f4ise/RemoteAnyToneD578/Docs/Arduino/digispark_attiny85_pinout.jpg

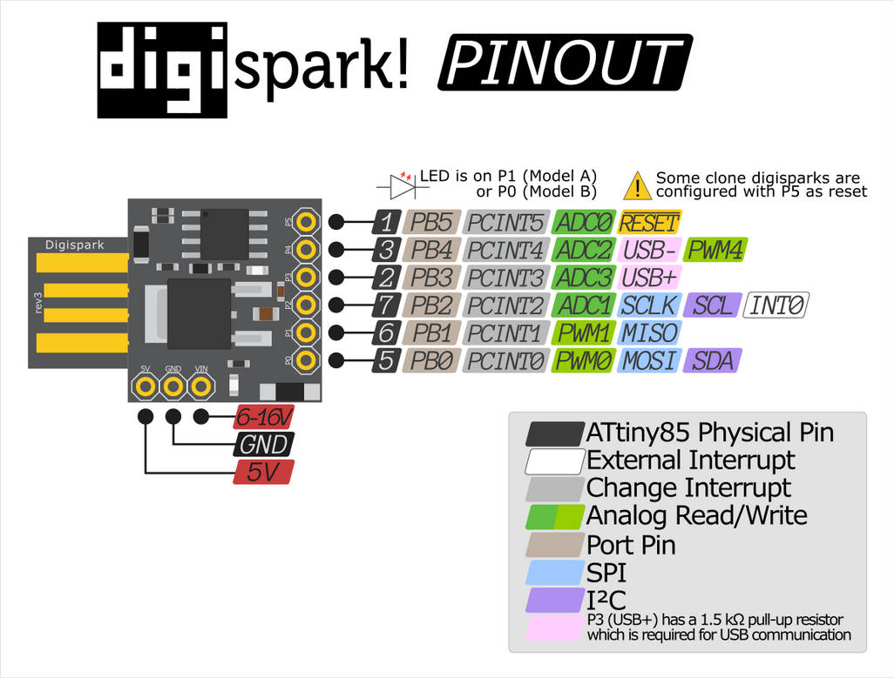
Docs/Arduino/digispark_attiny85_pinout.jpg
