f4ise/RemoteAnyToneD578/Docs/ds3231_schematic.png

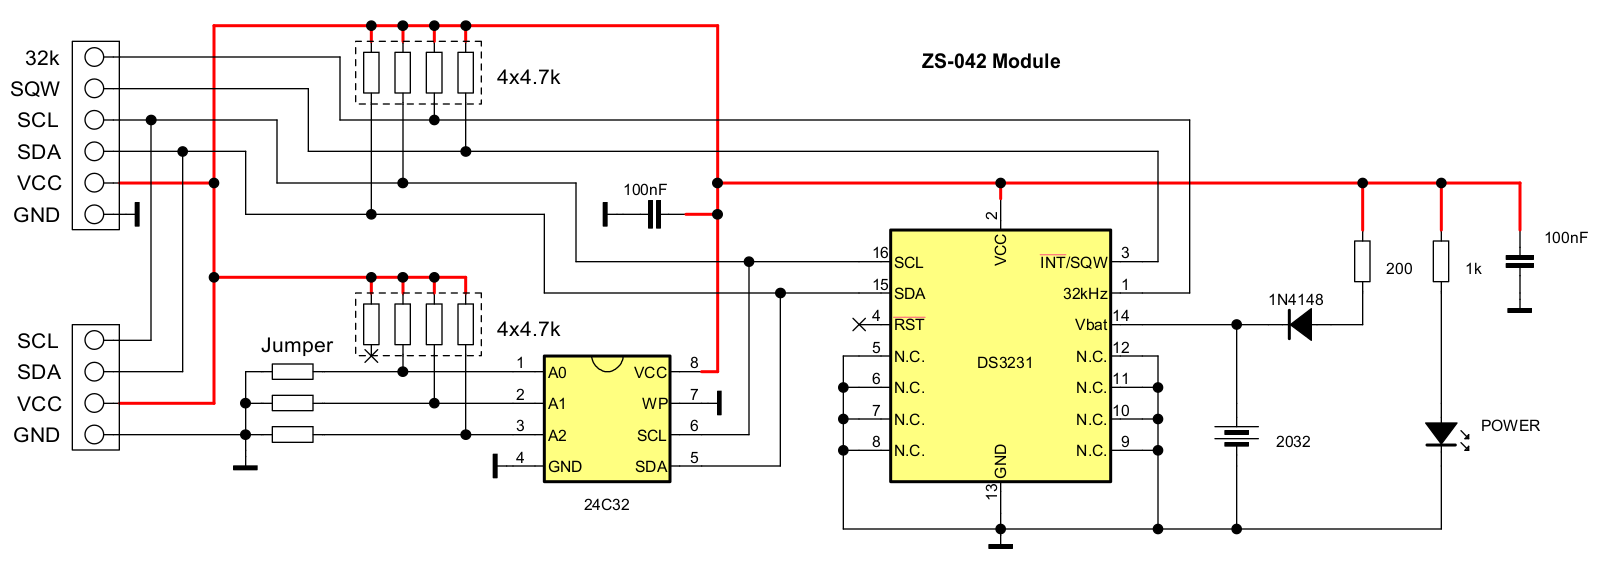
Docs/ds3231_schematic.png
