f4ise/RemoteAnyToneD578/Docs/Kenwoodbaofengcombdiag.png

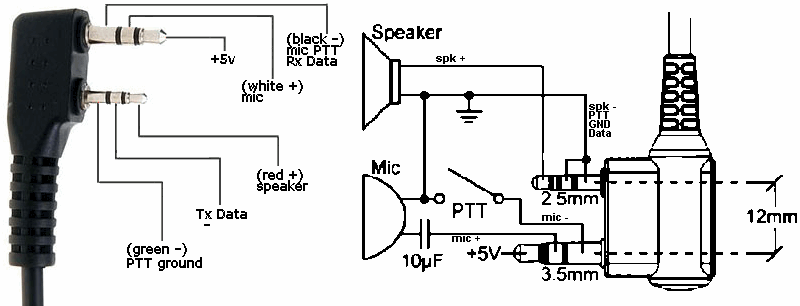
Docs/Kenwoodbaofengcombdiag.png
