f4ise/RemoteAnyToneD578/Docs/MT8870-DTMF-Module-Schematic.png

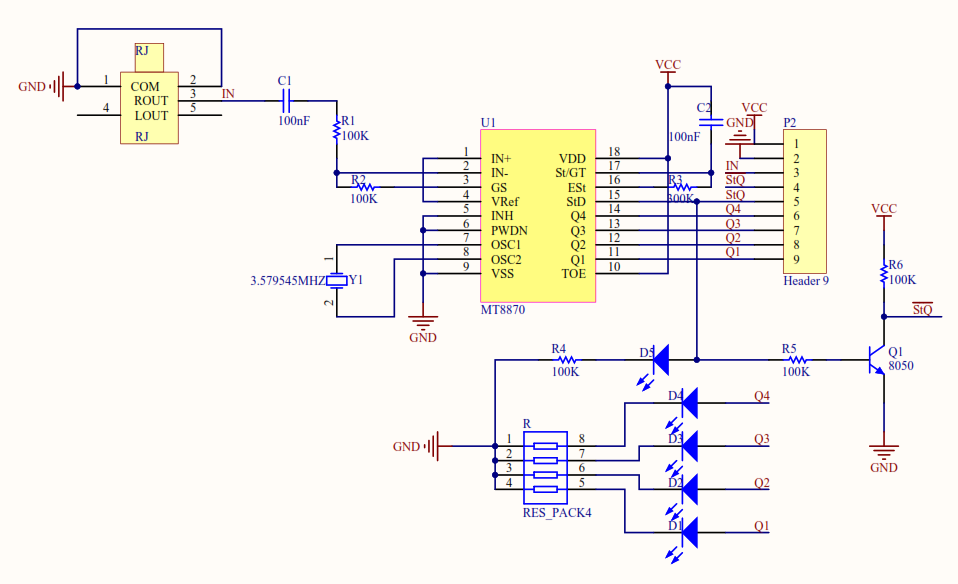
Docs/MT8870-DTMF-Module-Schematic.png
