f4ise/RemoteAnyToneD578/Docs/PARIS_Morse_Code_Timing.png

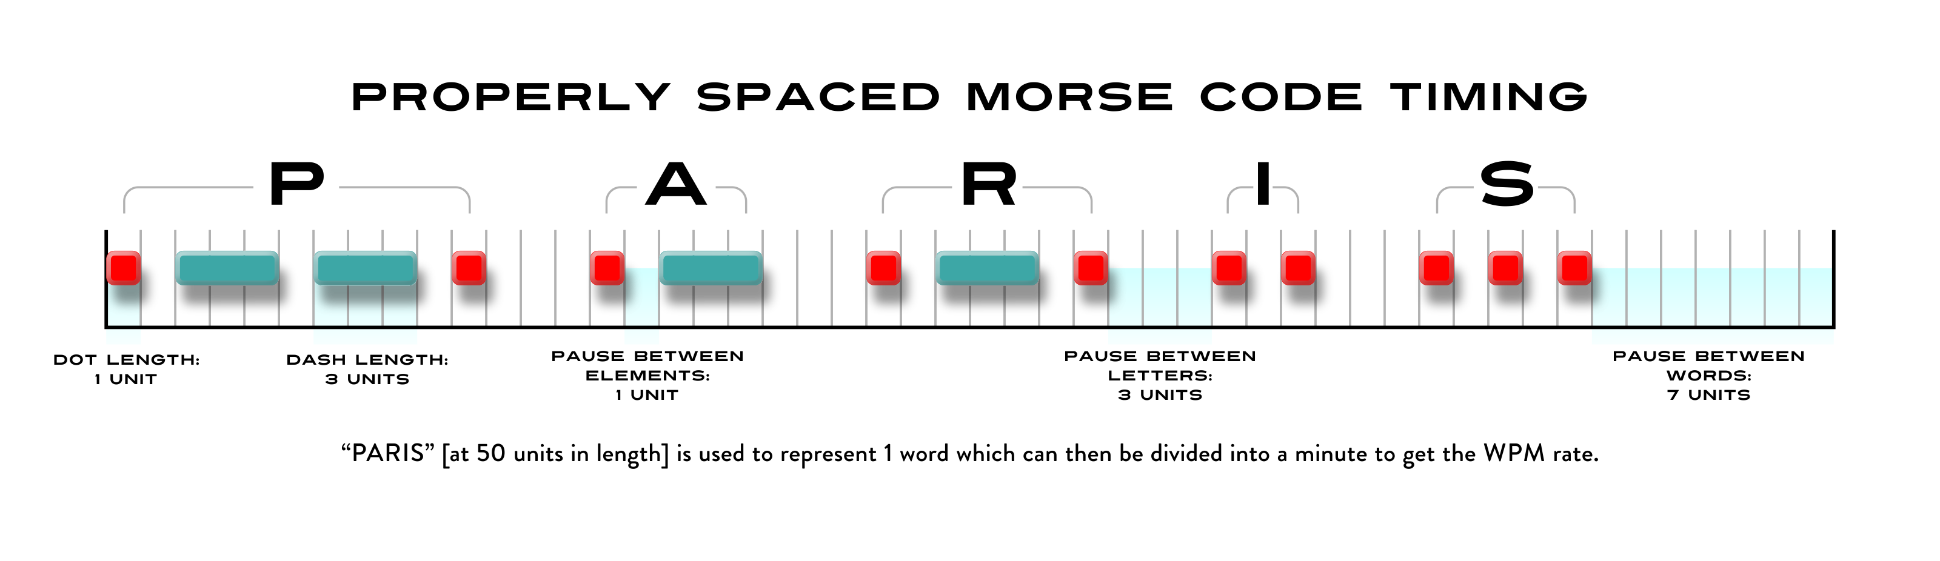
Docs/PARIS_Morse_Code_Timing.png
