f4ise/RemoteAnyToneD578/Docs/pcf8575_mod_schematic.png

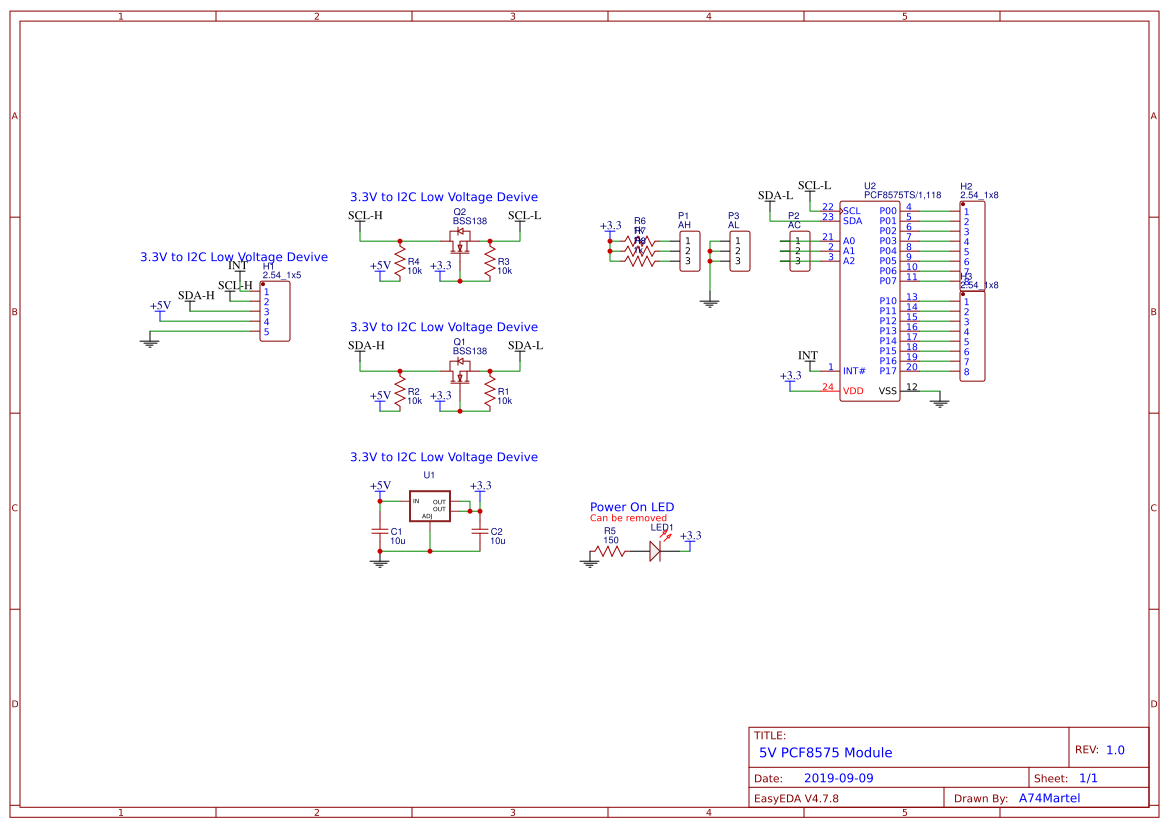
Docs/pcf8575_mod_schematic.png
