f4ise/RemoteAnyToneD578/Docs/Arduino/A000067-schematics.pdf

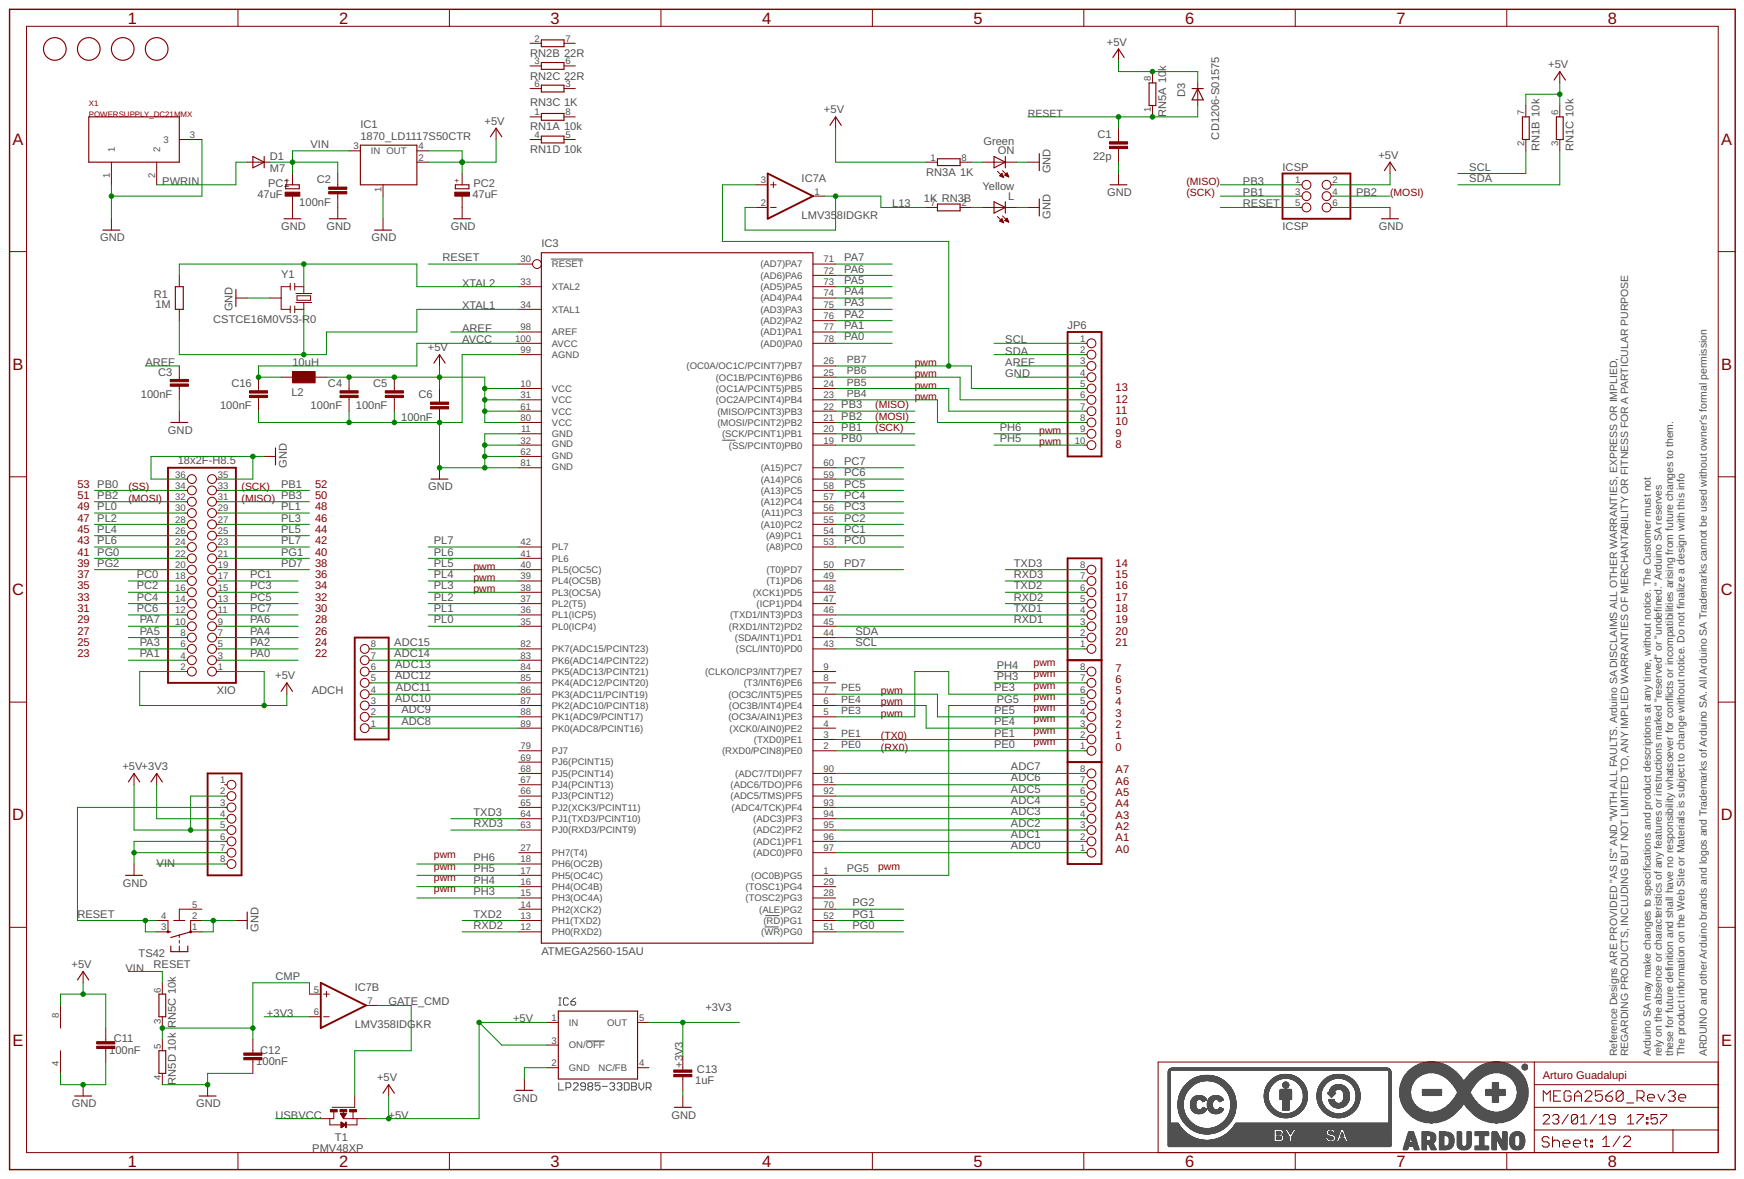
[picture p7: page 1]

Reference Designs ARE PROVIDED "AS IS" AND "WITH ALL FAULTS. Arduino SA DISCLAIMS ALL OTHER WARRANTIES, EXPRESS OR IMPLIED, REGARDING PRODUCTS, INCLUDING BUT NOT LIMITED TO, ANY IMPLIED WARRANTIES OF MERCHANTABILITY OR FITNESS FOR A PARTICULAR PURPOSE Arduino SA may make changes to specifications and product descriptions at any time, without notice. The Customer must not rely on the absence or characteristics of any features or instructions marked "reserved" or "undefined." Arduino SA reserves these for future definition and shall have no responsibility whatsoever for conflicts or incompatibilities arising from future changes to them. The product information on the Web Site or Materials is subject to change without notice. Do not finalize a design with this info ARDUINO and other Arduino brands and logos and Trademarks of Arduino SA. All Arduino SA Trademarks cannot be used without owner's formal permission ICSP +5V GND +5V GND GND +5V GND 47uF 47uF GND GND GND GND Green GND +5V M7 GND 1870_LD1117S50CTR 100nFGND 100nF 100nF +3V3 +5V +5V ATMEGA2560-15AU 100nF 100nF 22p+5V GND Yellow GND CSTCE16M0V53-R0 GND 1M 10k 10k 10k 10k 10k 1K 1K 1K22R 22R TS42 LMV358IDGKR CD1206-S01575 18x2F-H8.5 +5VGND 10uH 100nF 1uF PMV48XP GND 100nF GND +5V 100nF +5V GND 10k 10k GND LMV358IDGKR 1 2 3 4 5 6 ICSP 12345678 PC1 PC2 ON D1 1 1 2 2 3 3 1 IN 3 OUT 42 IC1 C3 C6 C2 1234567812345678 (A8)PC0 53 (A9)PC1 54 (A10)PC2 55 (A11)PC3 56 (A12)PC4 57 (A13)PC5 58 (A14)PC6 59 (A15)PC7 60 (AD0)PA0 78 (AD1)PA1 77 (AD2)PA2 76 (AD3)PA3 75 (AD4)PA4 74 (AD5)PA5 73 (AD6)PA6 72 (AD7)PA7 71 (ADC0)PF0 97 (ADC1)PF1 96 (ADC2)PF2 95 (ADC3)PF3 94 (ADC4/TCK)PF4 93 (ADC5/TMS)PF5 92 (ADC6/TDO)PF6 91 (ADC7/TDI)PF7 90 (ALE)PG2 70 (CLKO/ICP3/INT7)PE7 9 (ICP1)PD4 47 (MISO/PCINT3)PB3 22 (MOSI/PCINT2)PB2 21 (OC0A/OC1C/PCINT7)PB7 26 (OC0B)PG5 1 (OC1A/PCINT5)PB5 24 (OC1B/PCINT6)PB6 25 (OC2A/PCINT4)PB4 23 (OC3A/AIN1)PE3 5 (OC3B/INT4)PE4 6 (OC3C/INT5)PE5 7 (RD)PG1 52 (RXD0/PCIN8)PE0 2 (RXD1/INT2)PD2 45 (SCK/PCINT1)PB1 20 (SCL/INT0)PD0 43 (SDA/INT1)PD1 44 (SS/PCINT0)PB0 19 (T0)PD7 50 (T1)PD6 49 (T3/INT6)PE6 8 (TOSC1)PG4 29 (TOSC2)PG3 28 (TXD0)PE1 3 (TXD1/INT3)PD3 46 (WR)PG0 51 (XCK0/AIN0)PE2 4 (XCK1)PD5 48 AGND 99 AREF 98 AVCC 100 GND 11326281 PH0(RXD2) 12 PH1(TXD2) 13 PH2(XCK2) 14 PH3(OC4A) 15 PH4(OC4B) 16 PH5(OC4C) 17 PH6(OC2B) 18 PH7(T4) 27 PJ0(RXD3/PCINT9) 63 PJ1(TXD3/PCINT10) 64 PJ2(XCK3/PCINT11) 65 PJ3(PCINT12) 66 PJ4(PCINT13) 67 PJ5(PCINT14) 68 PJ6(PCINT15) 69 PJ7 79 PK0(ADC8/PCINT16) 89 PK1(ADC9/PCINT17) 88 PK2(ADC10/PCINT18) 87 PK3(ADC11/PCINT19) 86 PK4(ADC12/PCINT20) 85 PK5(ADC13/PCINT21) 84 PK6(ADC14/PCINT22) 83 PK7(ADC15/PCINT23) 82 PL0(ICP4) 35 PL1(ICP5) 36 PL2(T5) 37 PL3(OC5A) 38 PL4(OC5B) 39 PL5(OC5C) 40 PL6 41 PL7 42 RESET 30 VCC 10316180 XTAL1 34 XTAL2 33 GND GND GND VCC VCC VCC IC3 C4 C5 12345678 ADCH C1 L Y1 R1 1 8 RN5A 1 8 RN1A 2 7 RN1B 3 6 RN1C4 5 RN1D 1 8 RN3A 7 2 RN3B 6 3 RN3C 2 7 RN2B 3 6 RN2C 12 34 5 RESET 32 1 IC7A D3 2 1 4 3 6 5 8 7 10 9 12 11 14 13 16 15 18 17 20 19 22 21 24 23 26 25 28 27 30 29 32 31 34 33 36 35XIO 12345678910 JP6 12345678 L2 C16 C13 T1 C12 C11 3 6 RN5C 4 5 RN5DGND 2 IN 1 NC/FB 4 ON/OFF 3 OUT 5 56 7 IC7B 8 4 +5V +5V GND AREF AREF AREF RESET RESET RESET RESET VIN VIN VIN PWRIN ADC0 ADC2 ADC1 ADC3 ADC4 ADC5 ADC6 ADC7 +3V3 +3V3 +3V3 SDA SDA SDA SCL SCL SCL ADC9 ADC8 ADC10 ADC11 ADC12 ADC13 ADC14 ADC15 PB3 PB3 PB3 PB2 PB2 PB2 PB1 PB1 PB1 PB5 PB4 PE5 PE5 PE4 PE4 PE3 PE3 PE1 PE1 PE0 PE0 PB6 PH3 PH3 PH4 PH4 PH5 PH5 PH6 PH6 PG5 PG5RXD1 TXD1 RXD2 RXD2 RXD3 RXD3 TXD2 TXD2 TXD3 TXD3 PC0 PC0 PC1 PC1 PC2 PC2 PC3 PC3 PC4 PC4 PC5 PC5 PC6 PC6 PC7 PC7 PB0 PB0 PG0 PG0 PG1 PG1 PG2 PG2 PD7 PD7 PA0 PA0 PA1 PA1 PA2 PA2 PA3 PA3 PA4 PA4 PA5 PA5 PA6 PA6 PA7 PA7 PL0 PL0 PL1 PL1 PL2 PL2 PL3 PL3 PL4 PL4 PL5 PL5 PL6 PL6 PL7 PL7 PB7 XTAL2 XTAL1 L13 AVCC USBVCC GATE_CMD CMP 0123456789101112131516171819202114 (SCK) (MISO) (MOSI) pwm pwm pwm pwm pwm pwm pwm pwm pwm pwm pwm pwm pwm pwm pwm (TX0) (RX0) 5153 52 pwm pwm pwmpwm pwm (MISO) (SCK) (MOSI) (SS) (MOSI) (SCK) (MISO) 23 22 25 24 27 26 29 2830323436 31333537494745434139 50484644424038 pwm pwm pwm pwm pwm A7A6A5A4A3A2A1A0 Arturo Guadalupi ++ X1POWERSUPPLY_DC21MMX ABCDE 1 2 3 4 5 6 7 8 ABCDE 1 2 3 4 5 6 7 8

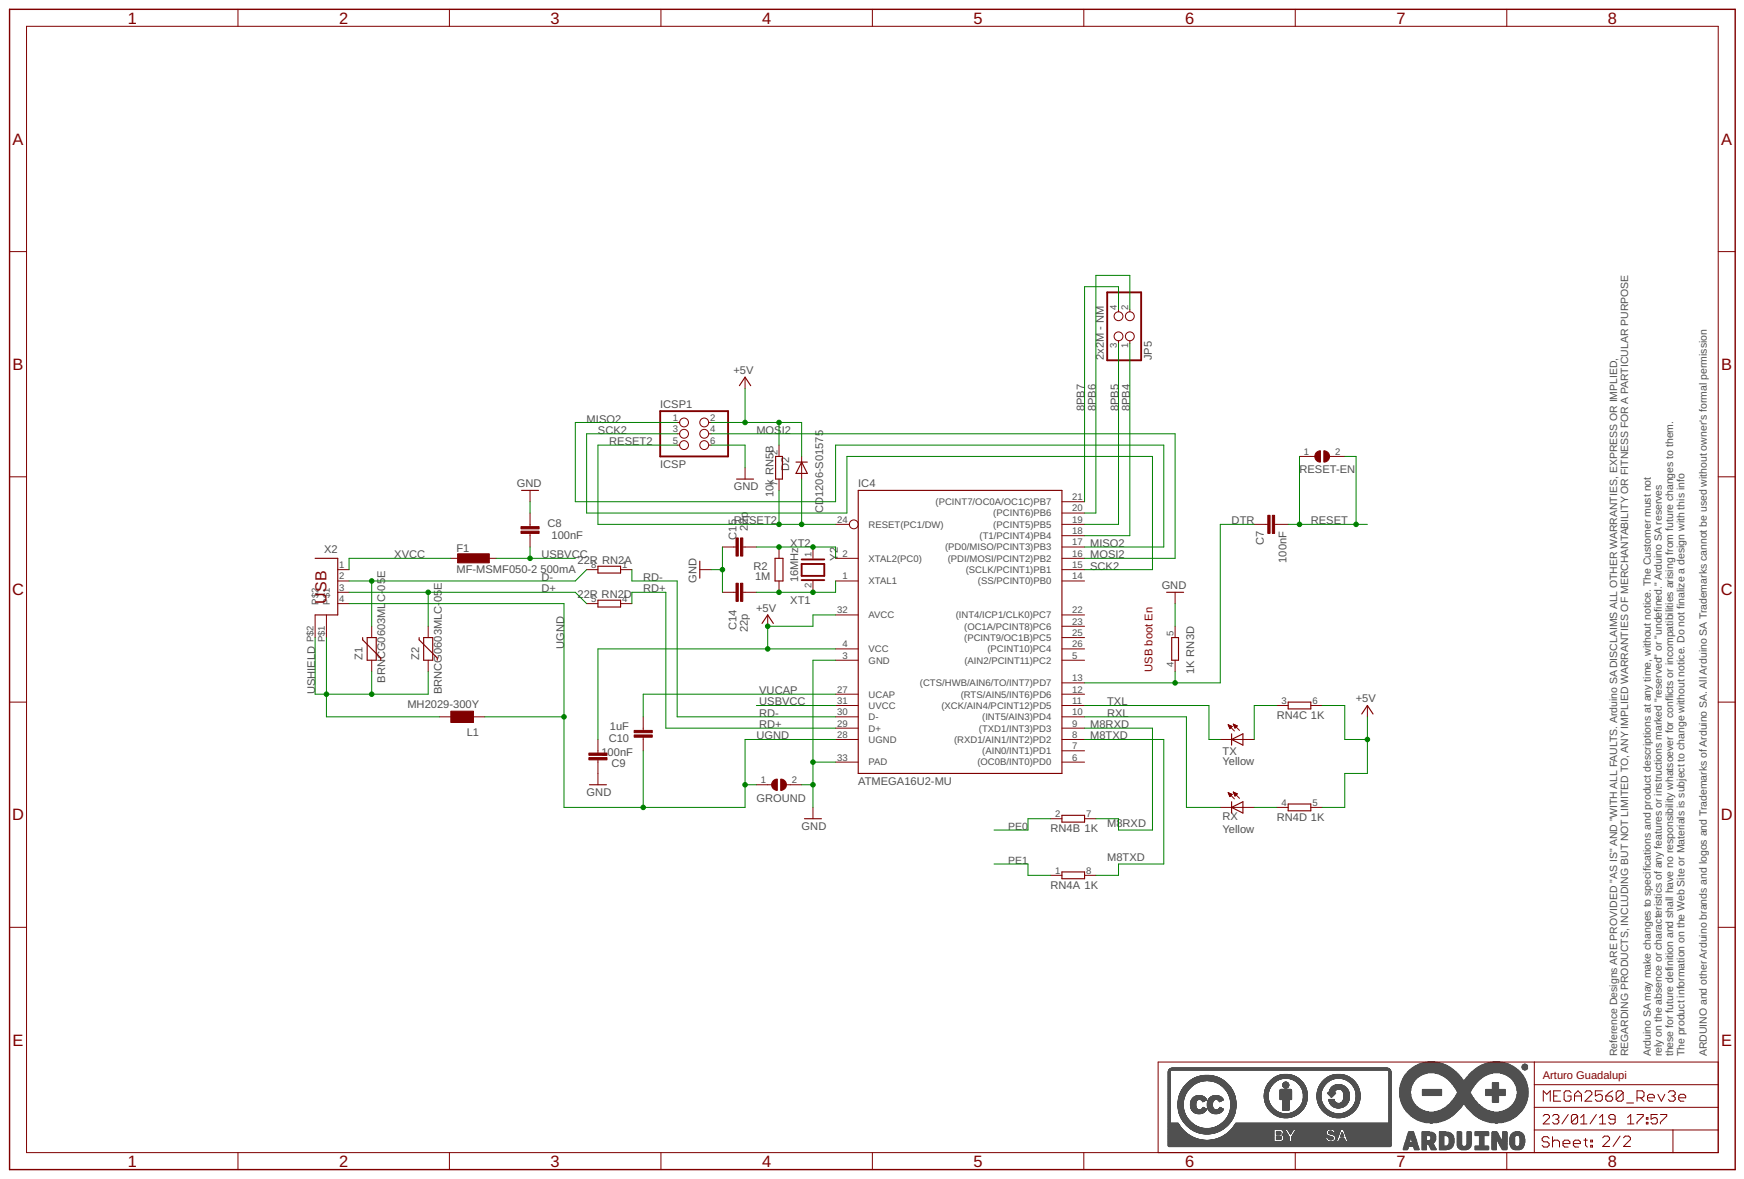
[picture p8: page 2]

Reference Designs ARE PROVIDED "AS IS" AND "WITH ALL FAULTS. Arduino SA DISCLAIMS ALL OTHER WARRANTIES, EXPRESS OR IMPLIED, REGARDING PRODUCTS, INCLUDING BUT NOT LIMITED TO, ANY IMPLIED WARRANTIES OF MERCHANTABILITY OR FITNESS FOR A PARTICULAR PURPOSE Arduino SA may make changes to specifications and product descriptions at any time, without notice. The Customer must not rely on the absence or characteristics of any features or instructions marked "reserved" or "undefined." Arduino SA reserves these for future definition and shall have no responsibility whatsoever for conflicts or incompatibilities arising from future changes to them. The product information on the Web Site or Materials is subject to change without notice. Do not finalize a design with this info ARDUINO and other Arduino brands and logos and Trademarks of Arduino SA. All Arduino SA Trademarks cannot be used without owner's formal permission 100nF GND Yellow Yellow MF-MSMF050-2 500mA +5V 100nF GND 100nF GND 1uF +5V ATMEGA16U2-MU ICSP +5V GND GND MH2029-300Y BRNCG0603MLC-05E BRNCG0603MLC-05E 1K1K 1K1K 10k 1K 22R 22R 1M 16MHz 22p 22p GND 2x2M - NM CD1206-S01575 C8 RXTX 123 P4 $1 P$1 P$2 P$2 X2 F1 C9 C7 1 2 RESET-EN C10 (AIN0/INT1)PD1 7 (AIN2/PCINT11)PC2 5 (CTS/HWB/AIN6/TO/INT7)PD7 13 (INT4/ICP1/CLK0)PC7 22 (INT5/AIN3)PD4 10 (OC0B/INT0)PD0 6 (OC1A/PCINT8)PC6 23 (PCINT5)PB5 19 (PCINT6)PB6 20 (PCINT7/OC0A/OC1C)PB7 21 (PCINT9/OC1B)PC5 25 (PCINT10)PC4 26 (PD0/MISO/PCINT3)PB3 17 (PDI/MOSI/PCINT2)PB2 16 (RTS/AIN5/INT6)PD6 12 (RXD1/AIN1/INT2)PD2 8 (SCLK/PCINT1)PB1 15 (SS/PCINT0)PB0 14 (T1/PCINT4)PB4 18 (TXD1/INT3)PD3 9 (XCK/AIN4/PCINT12)PD5 11 AVCC 32 D+ 29 D- 30 GND 3 PAD 33 RESET(PC1/DW) 24 UCAP 27 UGND 28 UVCC 31 VCC 4 XTAL1 1 XTAL2(PC0) 2 IC4 1 2 3 4 5 6 ICSP1 L1 Z1Z2 1 2 GROUND 1 8 RN4A 2 7 RN4B 3 6 RN4C 4 5 RN4D 2 7 RN5B 4 5 RN3D 8 1 RN2A 5 4 RN2D R2 1 2 Y2 C14 C15 1 2 3 4 JP5 D2 RESET M8RXD M8RXD M8TXD M8TXD PE1 PE0 DTR USBVCC USBVCC VUCAP RD- RD- RD+ RD+ RESET2 RESET2 MISO2 MISO2 MOSI2 MOSI2 SCK2 SCK2 XVCC RXL TXL D- D+ UGND UGND USHIELD XT2 XT1 8PB7 8PB6 8PB5 8PB4 USB boot En Arturo Guadalupi USB ABCDE 1 2 3 4 5 6 7 8 ABCDE 1 2 3 4 5 6 7 8
