f4ise/RemoteAnyToneD578/Hardware/RemoteDTMF_Mega/RemoteDTMF_Mega.pdf

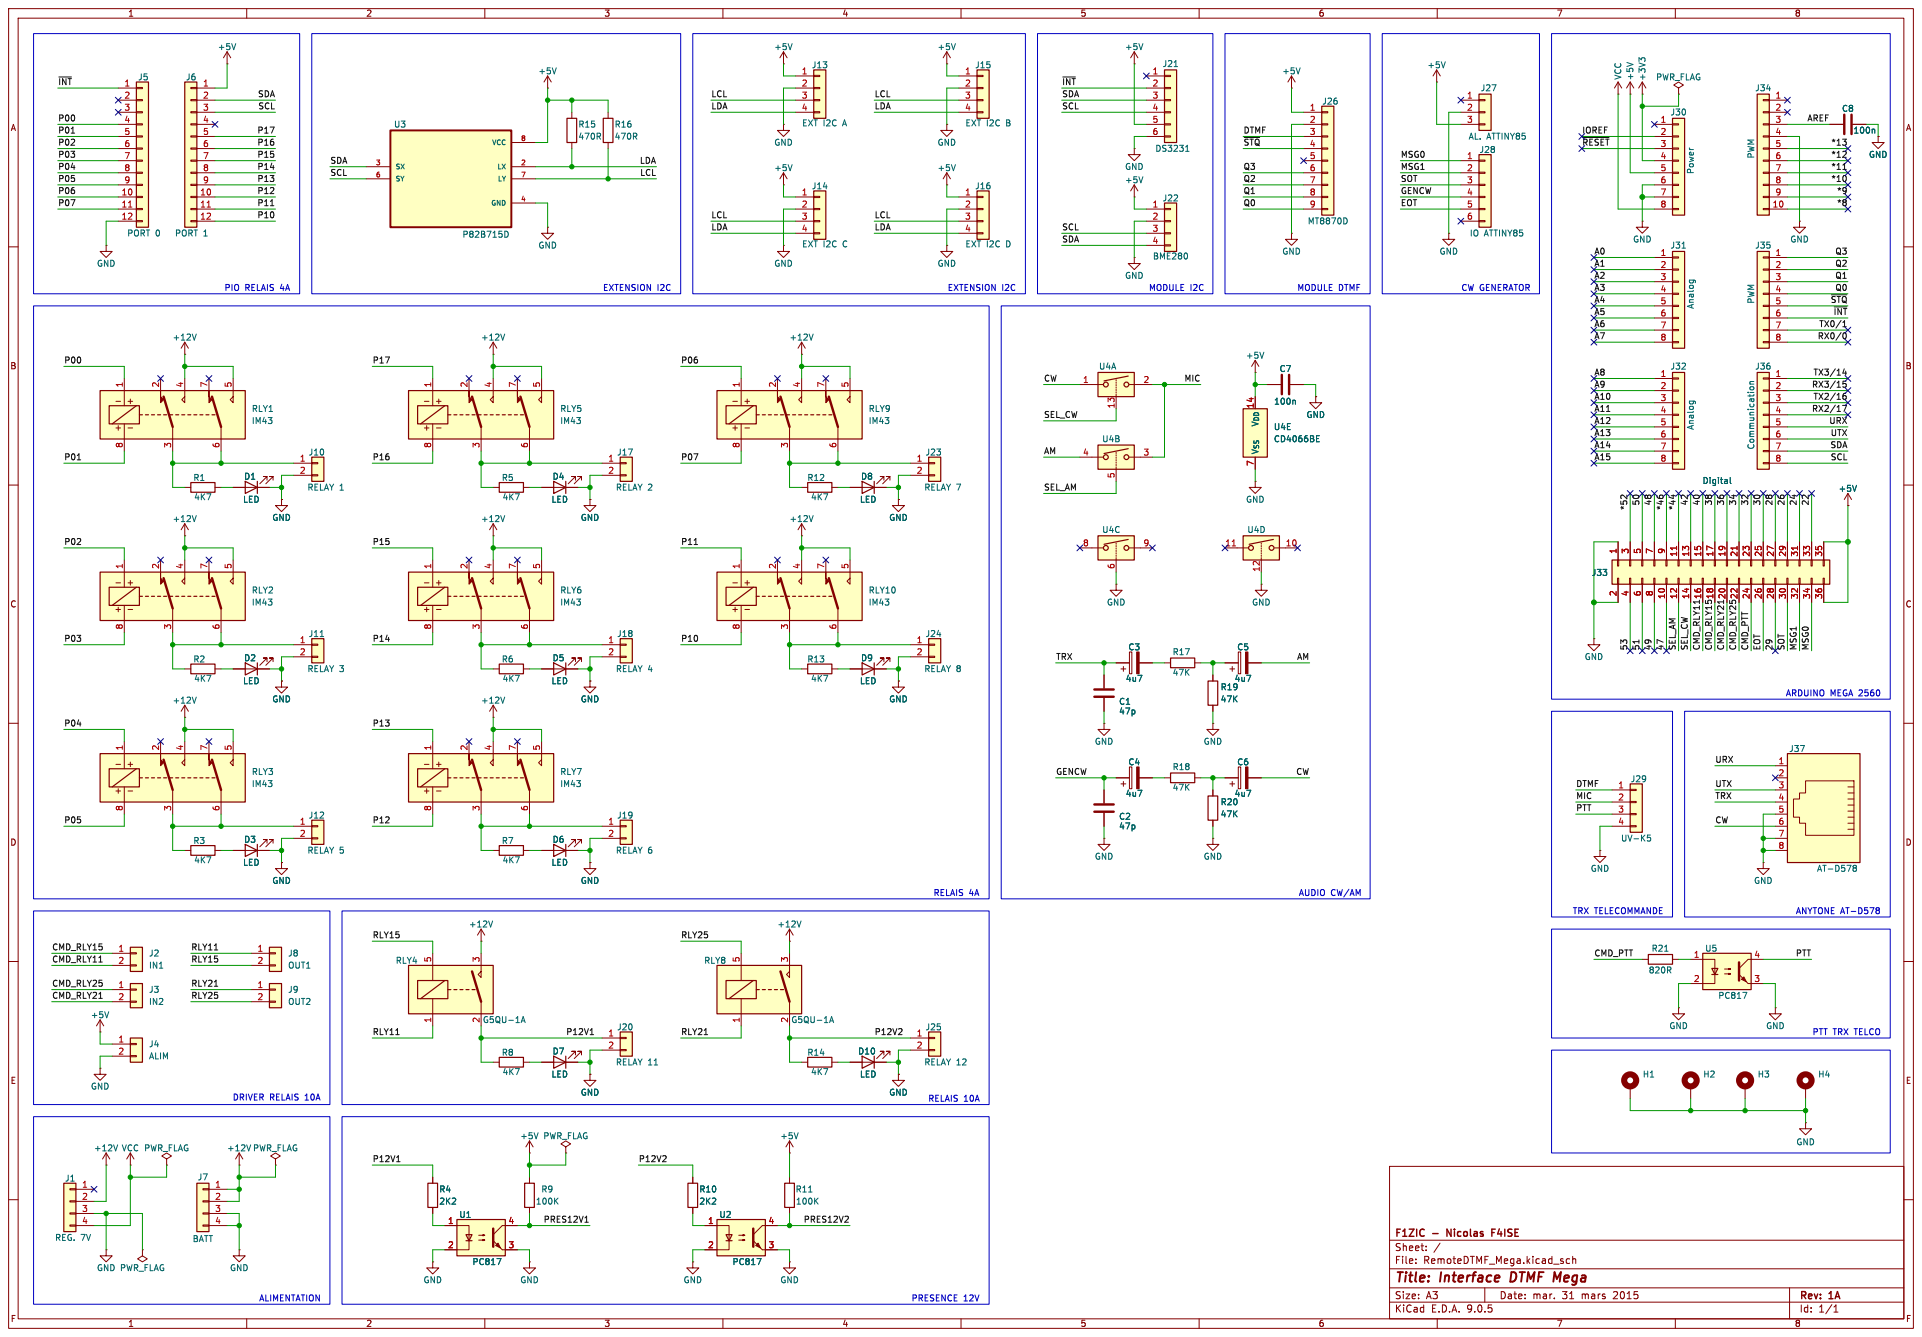
[picture p9: page 1]

Id: 1/1 Title: Interface DTMF Mega
