f4ise/RemoteAnyToneD578/Hardware/RemoteDTMF_Mini/RemoteDTMF.pdf

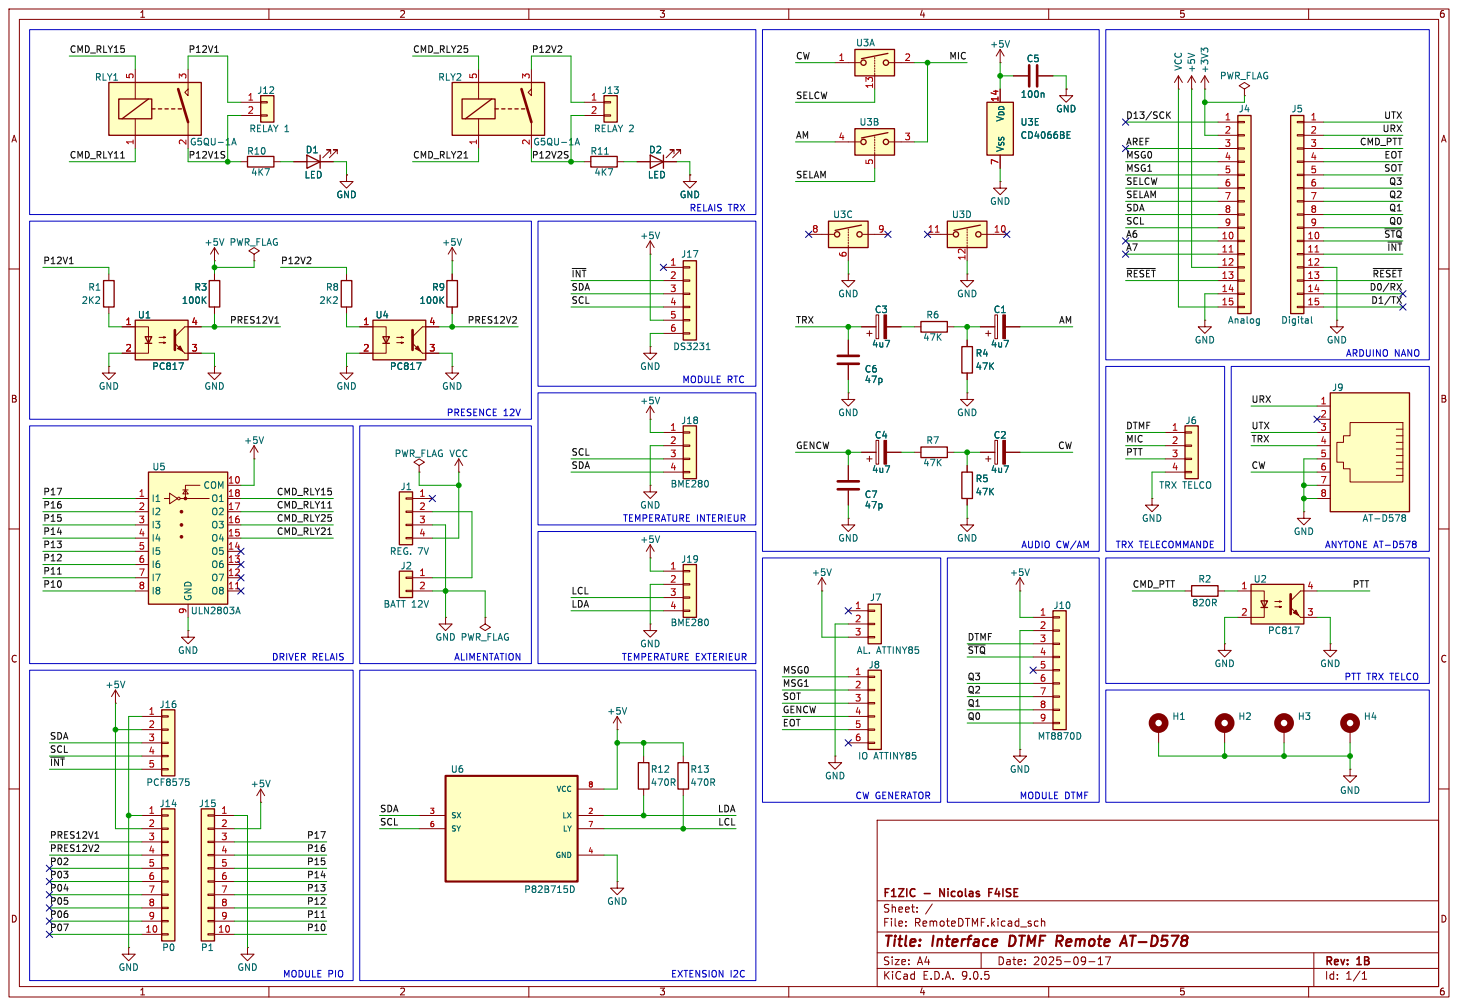
[picture p10: page 1]

SOT EOT URX AM

Id: 1/1 Title: Interface DTMF Remote AT-D578
