f4ise/RemoteAnyToneD578/Hardware/RemoteDTMF_ATD578/RemoteDTMF.pdf

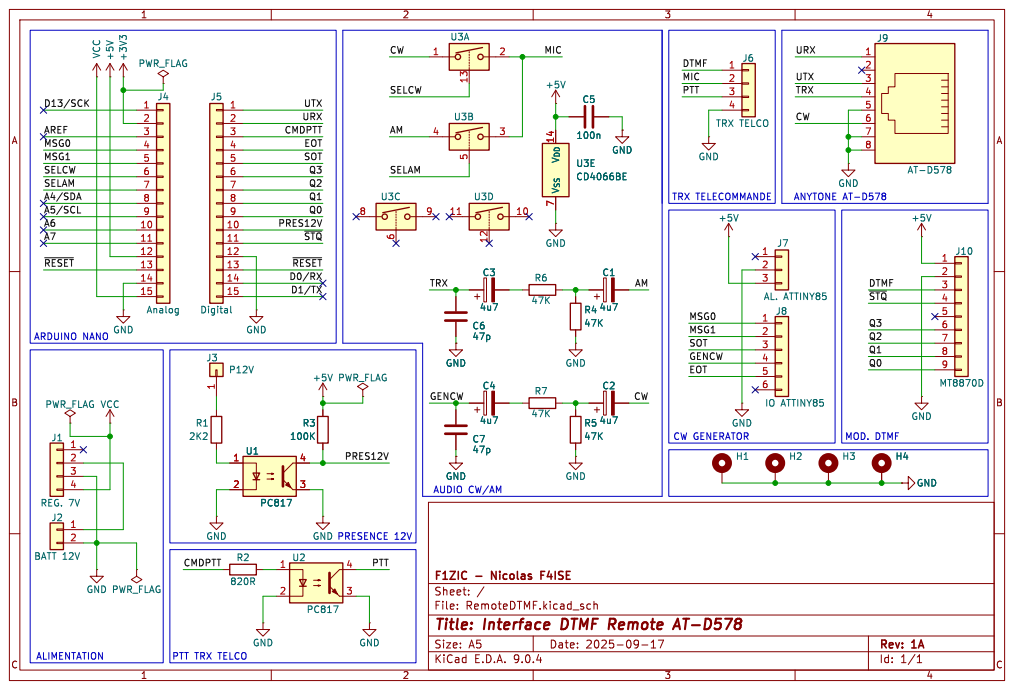
[picture p11: page 1]

Id: 1/1 Title: Interface DTMF Remote AT-D578
