f4ise/RemoteAnyToneD578/Hardware/RemoteDTMF_ATD578/RemoteDTMF.kicad_pcb

## KiCad design Hardware/RemoteDTMF_ATD578/RemoteDTMF.kicad_pcb (2025-09-25)

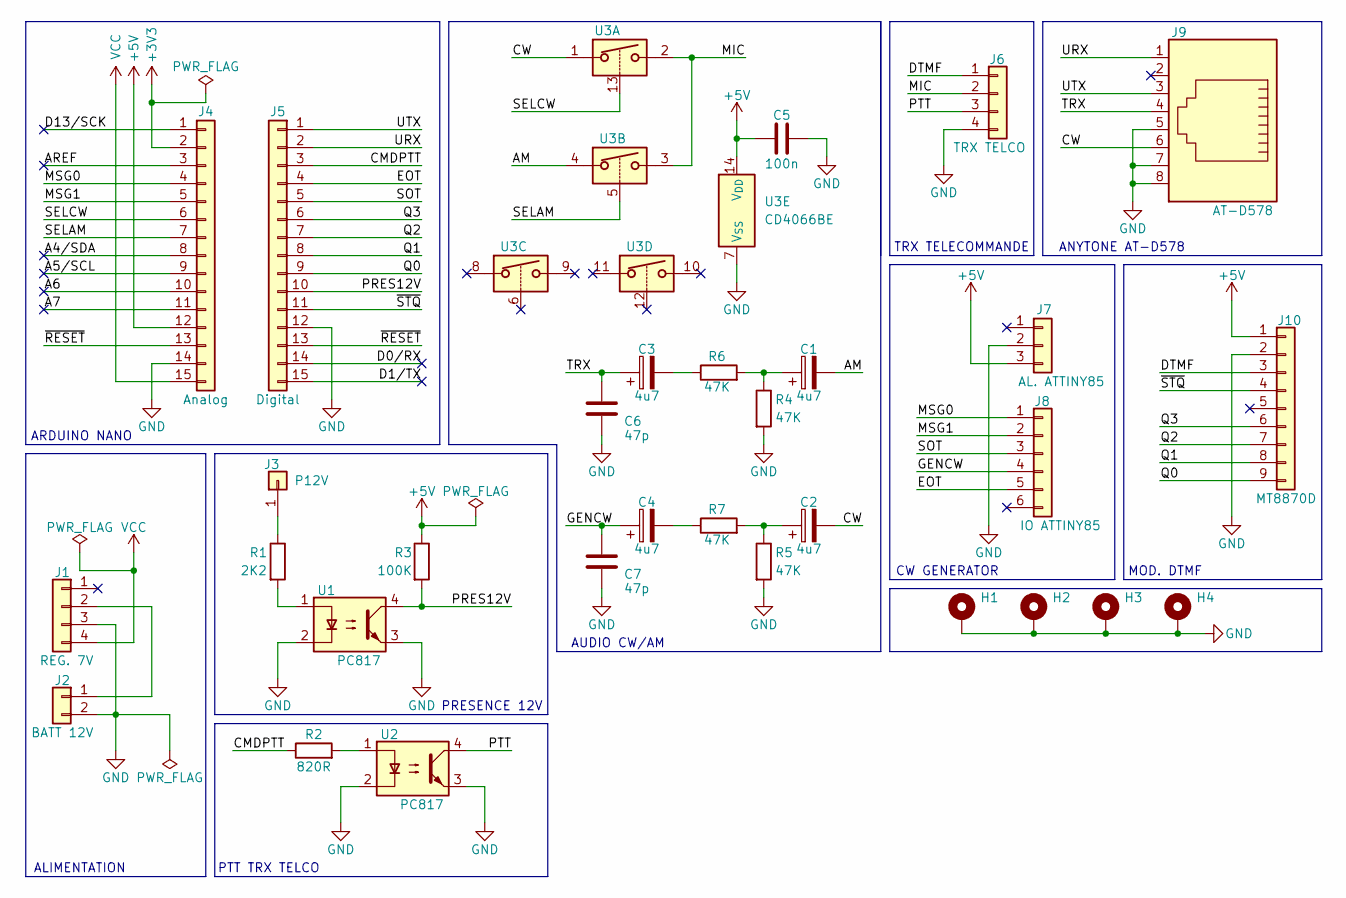
[picture p12: schematic RemoteDTMF.kicad_sch, Interface DTMF Remote AT-D578]

Parts:
C1, C2, C3, C4: 4u7; CP_Radial_D5.0mm_P2.50mm
C5: 100n; C_Rect_L7.0mm_W3.5mm_P5.00mm
C6, C7: 47p; C_Rect_L7.0mm_W3.5mm_P5.00mm
H1, H2, H3, H4: MountingHole_Pad; MountingHole_3.2mm_M3_DIN965_Pad
J1: REG. 7V; PinHeader_1x04_P2.54mm_Vertical
J2: BATT 12V; TerminalBlock_MaiXu_MX126-5.0-02P_1x02_P5.00mm
J3: P12V; PinHeader_1x01_P2.54mm_Vertical
J4: Analog; PinHeader_1x15_P2.54mm_Vertical
J5: Digital; PinHeader_1x15_P2.54mm_Vertical
J6: TRX TELCO; PinHeader_1x04_P2.54mm_Vertical
J7: AL. ATTINY85; PinHeader_1x03_P2.54mm_Vertical
J8: IO ATTINY85; PinHeader_1x06_P2.54mm_Vertical
J9: AT-D578; RJ45_Amphenol_54602-x08_Horizontal
J10: MT8870D; PinHeader_1x09_P2.54mm_Vertical
R1: 2K2; R_Axial_DIN0204_L3.6mm_D1.6mm_P7.62mm_Horizontal
R2: 820R; R_Axial_DIN0204_L3.6mm_D1.6mm_P7.62mm_Horizontal
R3: 100K; R_Axial_DIN0204_L3.6mm_D1.6mm_P7.62mm_Horizontal
R4, R5, R6, R7: 47K; R_Axial_DIN0204_L3.6mm_D1.6mm_P7.62mm_Horizontal
U1, U2: PC817; DIP-4_W7.62mm
U3: CD4066BE; DIP-14_W7.62mm

Connections:
+3V3: J4.2
+5V: C5.1, J4.12, J7.3, J10.1, R3.1, U3.14 (V_{DD})
/A4/SDA: J4.8
/A5/SCL: J4.9
/A6: J4.10
/A7: J4.11
/AM: C1.2, U3.4
/AREF: J4.3
/CMDPTT: J5.3, R2.1
/CW: C2.2, J9.6, U3.1
/D0/RX: J5.14
/D1/TX: J5.15
/D13/SCK: J4.1
/DTMF: J6.1, J10.3
/EOT: J5.4, J8.5
/GENCW: C4.1, C7.1, J8.4
/MIC: J6.2, U3.2, U3.3
/MSG0: J4.4, J8.1
/MSG1: J4.5, J8.2
/PRES12V: J5.10, R3.2, U1.4
/PTT: J6.3, U2.4
/Q0: J5.9, J10.9
/Q1: J5.8, J10.8
/Q2: J5.7, J10.7
/Q3: J5.6, J10.6
/SELAM: J4.7, U3.5
/SELCW: J4.6, U3.13
/SOT: J5.5, J8.3
/TRX: C3.1, C6.1, J9.4
/URX: J5.2, J9.1
/UTX: J5.1, J9.3
/~RESET: J4.13, J5.13
/~STQ: J5.11, J10.4
GND: C5.2, C6.2, C7.2, H1.1, H2.1, H3.1, H4.1, J1.3, J2.2, J4.14, J5.12, J6.4, J7.2, J9.5, J9.7, J9.8, J10.2, R4.2, R5.2, U1.2, U1.3, U2.2, U2.3, U3.7 (V_{SS})
unnamed: C1.1, R4.1, R6.2
unnamed: C2.1, R5.1, R7.2
unnamed: C3.2, R6.1
unnamed: C4.2, R7.1
unnamed: J1.2, J2.1
unnamed: J3.1, R1.1
unnamed: R1.2, U1.1
unnamed: R2.2, U2.1
VCC: J1.4, J4.15

Notes on the sheet:
ALIMENTATION
ARDUINO NANO
AUDIO CW/AM
ANYTONE AT-D578
TRX TELECOMMANDE
MOD. DTMF
PRESENCE 12V
PTT TRX TELCO
CW GENERATOR

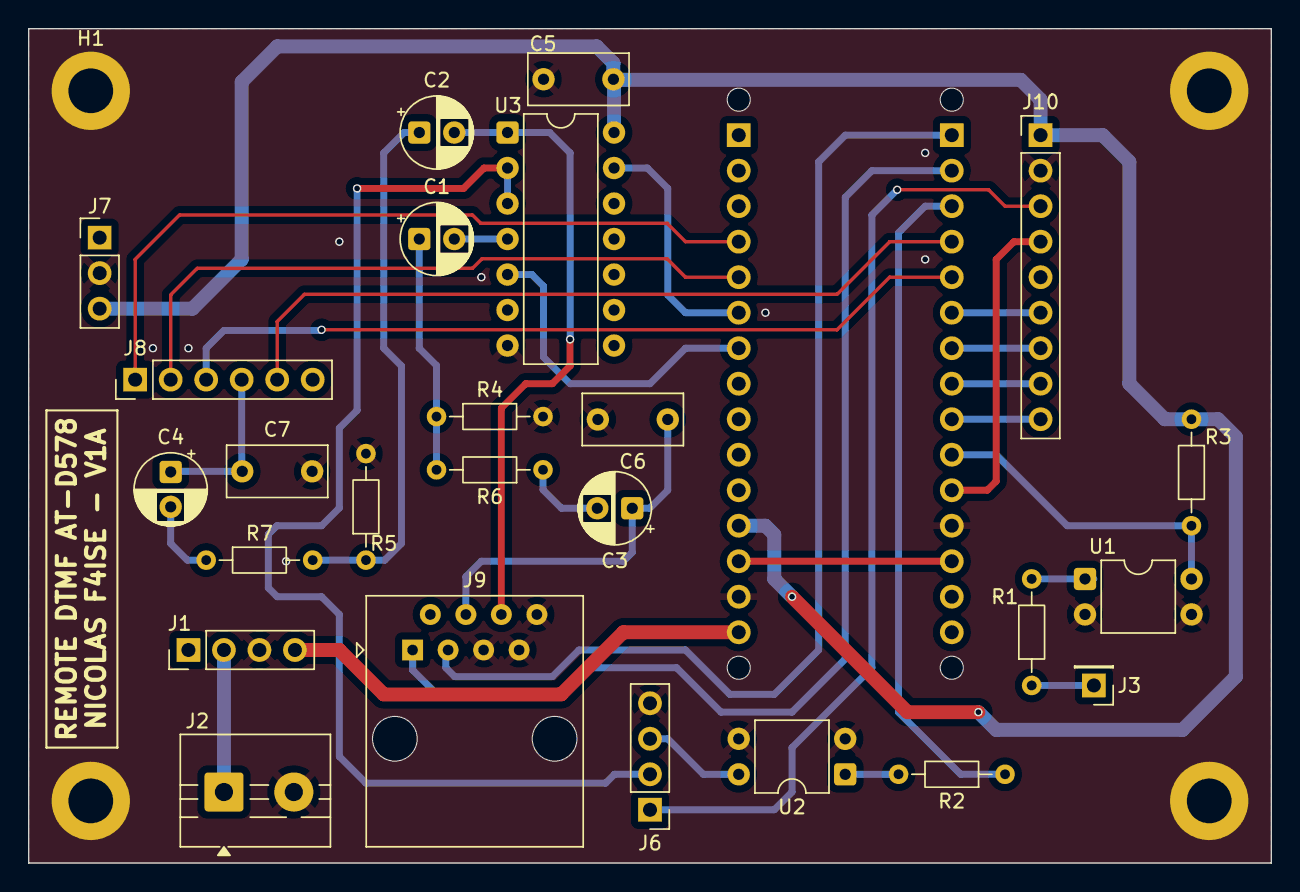
[picture p13: board RemoteDTMF.kicad_pcb from above]

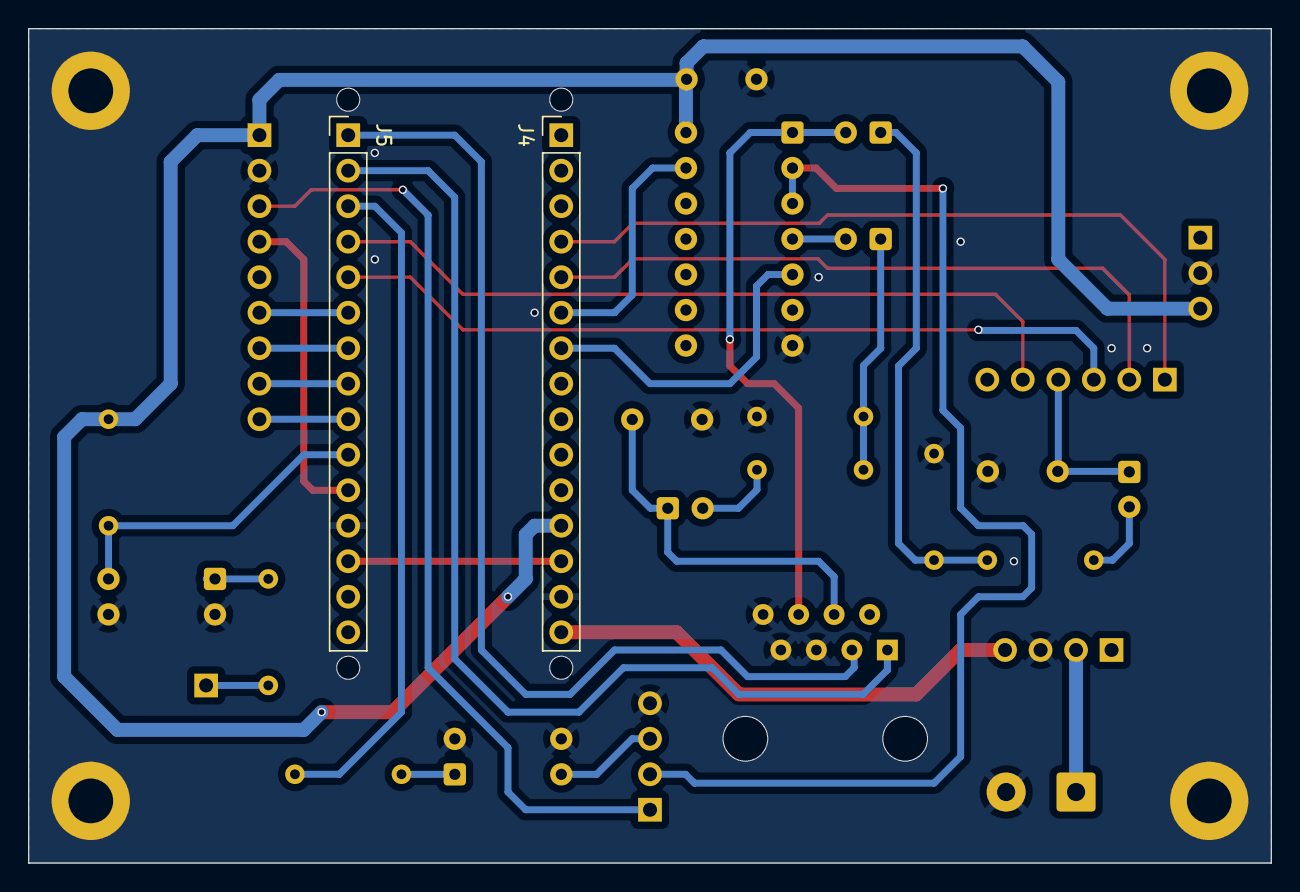
[picture p14: board RemoteDTMF.kicad_pcb from below]

Board: 2 copper layers, 88.9 x 59.7 mm, 35 parts (2 on the bottom side), 34 nets.

Other parts of the board:
MH1, MH2, MH3, MH4: MountingHole_65mil
