f4ise/RemoteAnyToneD578/Hardware/RemoteDTMF_Mega/RemoteDTMF_Mega.kicad_pcb

## KiCad design Hardware/RemoteDTMF_Mega/RemoteDTMF_Mega.kicad_pcb (2025-10-18)

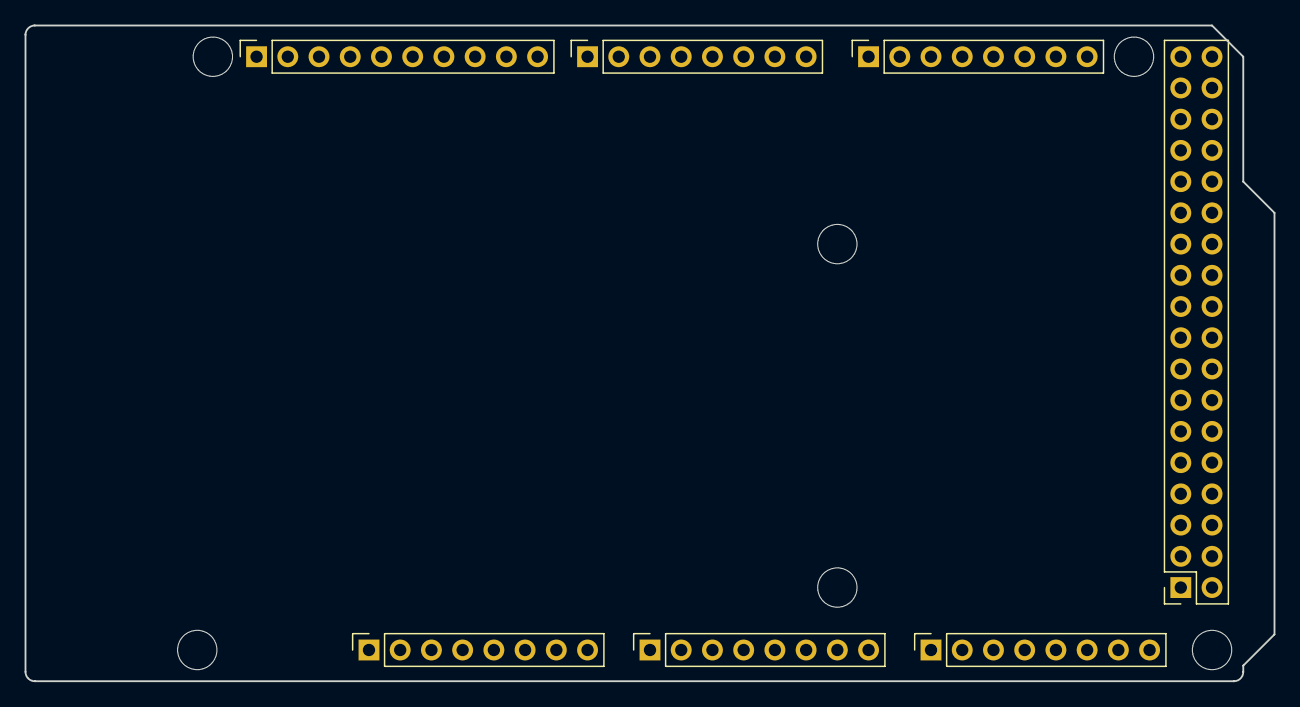
[picture p15: board RemoteDTMF_Mega.kicad_pcb from above]

Board: 2 copper layers, 101.6 x 53.3 mm, 13 parts (0 on the bottom side), 4 nets, no tracks yet.

Parts:
J1: Power; PinSocket_1x08_P2.54mm_Vertical
J2: PWM; PinSocket_1x10_P2.54mm_Vertical
J3, J5: Analog; PinSocket_1x08_P2.54mm_Vertical
J4: PWM; PinSocket_1x08_P2.54mm_Vertical
J6: Communication; PinSocket_1x08_P2.54mm_Vertical
J7: Digital; PinSocket_2x18_P2.54mm_Vertical
MH1, MH2, MH3, MH4, MH5, MH6: MountingHole_3.2mm

Connections:
+5V: J1.5, J7.35, J7.36
/SCL/21: J2.1, J6.8
/SDA/20: J2.2, J6.7
GND: J1.6, J1.7, J2.4, J7.1, J7.2
