f4ise/RemoteAnyToneD578/Software/RemoteDTMF/src/main.cpp

#include <Arduino.h>
#include <EEPROM.h>
#include <SoftwareSerial.h>
#include <Wire.h>

#include <ErriezSerialTerminal.h>
#include <SparkFunBME280.h>
#include <DS3231.h>
#include <PCF8575.h>

#include "config.h"
#include "d578.h"
#include "dtmf.h"

// RTC Clock
DS3231 rtc;
// Temperature Sensor
BME280 SensorInt;
BME280 SensorExt;
// PIO Extension
PCF8575 pio(0x20);

// DTMF
void taskDTMF(void);
uint8_t bufferTX[8] = {0x41, 0x00, 0x00, 0x00, 0x00, 0x00, 0x00, 0x06};
char cmdDTMF[4] = {0x00, 0x00, 0x00, 0x00};
uint8_t dtmfTimer = 0;

// CW/AM
void sendBeacon(void);
void sendAM(void);
void sendAck(int ack);
uint8_t repeatBeacon;
uint16_t sendBeaconTimer;
boolean enaBeacon = 0;

// AT-D578
SoftwareSerial swSerial(swRX, swTX);
int Pressed(uint8_t bp);
int longPressed(uint8_t bp);
void pttPressed(boolean onoff);
void sendKeepAlive(void);

// Terminal
SerialTerminal term('\n', ' ');

void cmdHelp();
void cmdGet();
void cmdSetBeacon();
void cmdSetAuto();
void cmdSetDate();
void cmdSetTime();
void cmdTemp();
void cmdVersion();
void cmdSave();
void cmdUnknown(const char *command);
void printConsoleChar(void);

// PIO
void enableRelay(uint8_t num, bool state);

// RTC
void taskRTC(void);
void intRTC_ISR(void);
void setAlarm(byte num);
void getDateStuff(byte& year, byte& month, byte& date, byte& dOW, byte& hour, byte& minute, byte& second);
volatile byte RTCtik = 0;
  // Alarme 1 START Relays
byte a1Hour;
byte a1Minute;
  // Alarme 2 STOP Relays
byte a2Hour;
byte a2Minute;


// Misc
void logs(uint8_t level);
void checkSecond(void);


unsigned long lastSecond;

// --  INIT  -------------------------------------------------------------
void setup() {
  
  int addr = 0;

  // Serial Debug
  Serial.begin(dbgSpeed);

  // Config IO GEN CW
  pinMode(EOT_CW, INPUT);
  pinMode(SOT_CW, OUTPUT);
  pinMode(MSG0_CW, OUTPUT);
  pinMode(MSG1_CW, OUTPUT);
  // Init IO GEN CW
  digitalWrite(SOT_CW, LOW);
  digitalWrite(MSG0_CW, LOW);
  digitalWrite(MSG1_CW, LOW);

  // Config IO Misc
  //pinMode(PRES12V1, INPUT);     // TBD IO
  //pinMode(PRES12V2, INPUT);     // TBD IO
  pinMode(intRTC, INPUT_PULLUP);
  pinMode(LED, OUTPUT);
  pinMode(CMDPTT, OUTPUT);
  pinMode(SW_CW, OUTPUT);
  pinMode(SW_AM, OUTPUT);
  // Init IO Misc  
  digitalWrite(CMDPTT, LOW);
  digitalWrite(SW_CW, LOW);
  digitalWrite(SW_AM, LOW);

  // Init I2C
  Wire.begin();

  // Init RTC
  setAlarm(1);
  setAlarm(2);
  attachInterrupt(digitalPinToInterrupt(intRTC), intRTC_ISR, FALLING);

  // Init BME280
  SensorExt.setI2CAddress(0x76);
  if(SensorExt.beginI2C() == false)
  {
    Serial.println(F("Sensor Ext connect failed"));
  }    
  SensorInt.setI2CAddress(0x77);
  if(SensorInt.beginI2C() == false)
  {
    Serial.println(F("Sensor Int connect failed"));
  } 
  // Init PIO
  if(pio.begin(0) == false)
  {
    Serial.println(F("PC8575 connect failed"));
  } 
  
  // Init EEPROM
  EEPROM.begin();  //Initialize EEPROM
  enaBeacon = EEPROM.read(addr);
  addr++;
  repeatBeacon = EEPROM.read(addr);
  addr++;
  a1Hour = EEPROM.read(addr);
  addr++;
  a1Minute = EEPROM.read(addr);
  addr++;
  a2Hour = EEPROM.read(addr);
  addr++;
  a2Minute = EEPROM.read(addr);

  
  if(enaBeacon == 1)
  {
    digitalWrite(LED, HIGH);
  }
  else
  {
    digitalWrite(LED, LOW);
  }

  // Serial D578
  swSerial.begin(swSPEED);

  // INIT DTMF
  initDTMF();
  
  // Init Beacon
  sendBeaconTimer = (60 * repeatBeacon);

  // Init Serial Terminal
  Serial.println();
  Serial.println(F("-- Remote DTMF AT-D578 --"));
  Serial.println(F("type '?' to display usage."));
  Serial.println();
  printConsoleChar();
  term.setDefaultHandler(cmdUnknown);
  term.addCommand("?", cmdHelp);
  term.addCommand("get", cmdGet);
  term.addCommand("setBeacon", cmdSetBeacon);
  term.addCommand("setAuto", cmdSetAuto);
  term.addCommand("setDate", cmdSetDate);
  term.addCommand("setTime", cmdSetTime);
  term.addCommand("temp", cmdTemp);
  term.addCommand("sav", cmdSave);
  term.addCommand("v", cmdVersion);
  term.setSerialEcho(true);
  term.setPostCommandHandler(printConsoleChar);
}

// --  PROGRAM  ----------------------------------------------------------
void loop() {
  
  taskDTMF();

  taskRTC();

  sendBeacon();

  checkSecond();  

  term.readSerial();

  delay(10);
}

// --  INTERRUPT  --------------------------------------------------------
void intRTC_ISR(void)
{
  RTCtik = 1;
}

// --  DTMF  -------------------------------------------------------------
void taskDTMF(void)
{
  // DTMF
  cmdDTMF[0] = 0;
  cmdDTMF[0] = readDTMF();
  
  if((cmdDTMF[2] == 0) &(cmdDTMF[1] == 0) &  (cmdDTMF[0] != 0))
  {        
    logs(INF);
    Serial.println(cmdDTMF[0]);

    switch (cmdDTMF[0])
    {
      case '0':
        Pressed(bp0);
        break;
      case '1':
        Pressed(bp1);
        break;    
      case '2':
        Pressed(bp2);
        break;      
      case '3':
        Pressed(bp3);
        break;
      case '4':
        Pressed(bp4);
        break;    
      case '5':
        Pressed(bp5);
        break;      
      case '6':
        Pressed(bp6);
        break;
      case '7':
        Pressed(bp7);
        break;    
      case '8':
        Pressed(bp8);
        break;      
      case '9':
        Pressed(bp9);
        break;
      case 'A':
        sendAck(Pressed(bpA));
        break;      
      case 'B':
        sendAck(Pressed(bpB));
        break;
      case 'C':
        sendAck(Pressed(bpC));
        break;    
      case 'D':
        sendAck(Pressed(bpD));
        break;      
      case '*':
        //Pressed(bpST);
        cmdDTMF[2] = cmdDTMF[0];
        cmdDTMF[0] = 0;
        dtmfTimer = timeOutDTMF;
        break;
      case '#':
        //Pressed(bpDH);
        cmdDTMF[2] = cmdDTMF[0];
        cmdDTMF[0] = 0;
        dtmfTimer = timeOutDTMF;
        break;

      default:
        break;
    }
  }

  if((cmdDTMF[2] != 0) & (cmdDTMF[1] == 0) & (cmdDTMF[0] != 0))
  {
    // Debug
    logs(INF);
    Serial.print(cmdDTMF[2]);
    Serial.println(cmdDTMF[0]);
    
    // Long press
    if(cmdDTMF[2] == '#')
    {
      switch (cmdDTMF[0])
      {
        case '0':
          cmdDTMF[1] = cmdDTMF[0];
          cmdDTMF[0] = 0;
          break;   
        case '1':
          cmdDTMF[1] = cmdDTMF[0];
          cmdDTMF[0] = 0;
          break;
        case '2':
          cmdDTMF[1] = cmdDTMF[0];
          cmdDTMF[0] = 0;
          break;
        case '3':
          cmdDTMF[1] = cmdDTMF[0];
          cmdDTMF[0] = 0;
          break;            
        case '4':
          cmdDTMF[1] = cmdDTMF[0];
          cmdDTMF[0] = 0;
          break;
        case '5':
          cmdDTMF[1] = cmdDTMF[0];
          cmdDTMF[0] = 0;
          break;   
        case '6':
          cmdDTMF[1] = cmdDTMF[0];
          cmdDTMF[0] = 0;
          break;
        case '7':
          cmdDTMF[1] = cmdDTMF[0];
          cmdDTMF[0] = 0;
          break;
        case '8':
          cmdDTMF[1] = cmdDTMF[0];
          cmdDTMF[0] = 0;
          break;            
        case '9':
          cmdDTMF[1] = cmdDTMF[0];
          cmdDTMF[0] = 0;
          break;             
        case 'A':
          sendAck(longPressed(bpA));
          cmdDTMF[2] = 0;
          break;      
        case 'B':
          longPressed(bpB);
          delay(200);
          longPressed(bpB);
          delay(200);
          sendAck(0xAA);
          sendAM();
          //longPressed(bpB);
          //delay(200);
          longPressed(bpB);
          delay(200);
          longPressed(bpB);
          cmdDTMF[2] = 0;
          break;
        case 'C':
          sendAck(longPressed(bpC));
          cmdDTMF[2] = 0;
          break;    
        case 'D':
          sendAck(longPressed(bpD));
          cmdDTMF[2] = 0;
          break;      
      }
    }   
  }
  
  if((cmdDTMF[2] != 0) & (cmdDTMF[1] != 0) & (cmdDTMF[0] != 0))
  {
    // Debug
    logs(INF);
    Serial.print(cmdDTMF[2]);
    Serial.print(cmdDTMF[1]);
    Serial.println(cmdDTMF[0]);
    
    // CMD ON/OFF
    if(cmdDTMF[2] == '#')
    {
      switch (cmdDTMF[1])
      {
        case '0':
          if(cmdDTMF[0] == '0')
          {
            enaBeacon = 0;
            digitalWrite(LED, LOW);
            logs(INF);
            Serial.println("BEACON DISABLE");
            sendAck(0xAA);
          }
          if(cmdDTMF[0] == '1')
          {
            enaBeacon = 1;
            digitalWrite(LED, HIGH);
            logs(INF);
            Serial.println("BEACON ENABLE");
            sendBeaconTimer = (60 * repeatBeacon);
            sendAck(0xAA);
          }
          break;   
        case '1':
          if(cmdDTMF[0] == '0')
          {
            enableRelay(0, 0);
            Serial.println("RLY 1 OFF");
            sendAck(0xAA);
          }
          if(cmdDTMF[0] == '1')
          {
            enableRelay(0, 1);
            Serial.println("RLY 1 ON");
            sendAck(0xAA);
          }
          break;
        case '2':
          if(cmdDTMF[0] == '0')
          {
            enableRelay(1, 0);
            Serial.println("RLY 2 OFF");
            sendAck(0xAA);
          }
          if(cmdDTMF[0] == '1')
          {
            enableRelay(1, 1);
            Serial.println("RLY 2 ON");
            sendAck(0xAA);
          }
          break;
        case '3':
          if(cmdDTMF[0] == '0')
          {
            sendAck(Pressed(bpDN));
          }
          if(cmdDTMF[0] == '1')
          {
            sendAck(Pressed(bpUP));
          }          
          break;            
        case '4':
          sendAck(Pressed(bpSAB));
          break;          
      }
    }
    cmdDTMF[2] = 0;
    cmdDTMF[1] = 0;
  }

  // Timeout DTMF for no reception after * or #
  if((cmdDTMF[2] != 0) & (cmdDTMF[1] == 0) & (cmdDTMF[0] == 0) & (dtmfTimer == 0))
  {
    cmdDTMF[2] = 0;
    logs(WAR);
    Serial.println(F("Timeout receive DTMF"));
  }

  delay(30);
}

// --  RTC  --------------------------------------------------------------
void taskRTC(void)
{
  if(RTCtik)
  {    
    Serial.println(F("INT RTC DETECTED"));

    RTCtik = 0;

    bool intA1 = rtc.checkIfAlarm(1, false);
    bool intA2 = rtc.checkIfAlarm(2, false);

    Serial.print(intA1);
    Serial.print(' ');
    Serial.println(intA2);

    if(intA1)
    {
      enableRelay(0, 1);
      enableRelay(1, 1);
      rtc.checkIfAlarm(1, true);
      Serial.println(F("RELAIS 1 & 2 ON"));
    }    
    if(intA2)
    {
      enableRelay(0, 0);
      enableRelay(1, 0);
      rtc.checkIfAlarm(2, true);
      Serial.println(F("RELAIS 1 & 2 OFF"));
    }


  }
}

void setAlarm(byte num)
{
  if(num == 1)
  {
    rtc.turnOffAlarm(1);
    rtc.setA1Time(0, a1Hour, a1Minute, 0, 0b00001000, false, false, false);
    rtc.turnOnAlarm(1);
    rtc.checkIfAlarm(1, true);
  }

  if(num == 2)
  {
    rtc.turnOffAlarm(2);
    rtc.setA2Time(0, a2Hour, a2Minute, 0b01000000, false, false, false);
    rtc.turnOnAlarm(2);
    rtc.checkIfAlarm(2, true);
  }
}

void getDateStuff(byte& year, byte& month, byte& date, byte& dOW, byte& hour, byte& minute, byte& second) 
{
    // Call this if you notice something coming in on
    // the serial port. The stuff coming in should be in
    // the order YYMMDDwHHMMSS, with an 'x' at the end.
    boolean gotString = false;
    char inChar;
    byte temp1, temp2;
    char inString[20];
    
    byte j=0;
    while (!gotString) {
        if (Serial.available()) {
            inChar = Serial.read();
            inString[j] = inChar;
            j += 1;
            if (inChar == 'x') {
                gotString = true;
            }
        }
    }
    Serial.println(inString);
    // Read year first
    temp1 = (byte)inString[0] -48;
    temp2 = (byte)inString[1] -48;
    year = temp1*10 + temp2;
    // now month
    temp1 = (byte)inString[2] -48;
    temp2 = (byte)inString[3] -48;
    month = temp1*10 + temp2;
    // now date
    temp1 = (byte)inString[4] -48;
    temp2 = (byte)inString[5] -48;
    date = temp1*10 + temp2;
    // now Day of Week
    dOW = (byte)inString[6] - 48;
    // now hour
    temp1 = (byte)inString[7] -48;
    temp2 = (byte)inString[8] -48;
    hour = temp1*10 + temp2;
    // now minute
    temp1 = (byte)inString[9] -48;
    temp2 = (byte)inString[10] -48;
    minute = temp1*10 + temp2;
    // now second
    temp1 = (byte)inString[11] -48;
    temp2 = (byte)inString[12] -48;
    second = temp1*10 + temp2;
}

// --  AUDIO CW/AM  ------------------------------------------------------
void sendBeacon(void)
{
  // Send beacon
  if((sendBeaconTimer == 0) & (enaBeacon))
  {
    logs(INF);
    Serial.println(F("Send Beacon"));

    cmdDTMF[0] = 0;
    cmdDTMF[1] = 0;
    cmdDTMF[2] = 0;

    //PTT ON
    pttPressed(1);
    delay(1000);
    // logs(INF);
    // Serial.print(F("PTT ON.."));
    digitalWrite(MSG0_CW, HIGH);
    digitalWrite(SOT_CW, HIGH);

    while(digitalRead(EOT_CW) == 0)
    {
      checkSecond();
      delay(30);
    }

    // PTT OFF
    digitalWrite(SOT_CW, LOW);
    pttPressed(0);
    // Serial.println(F("..PTT OFF"));
    // logs(INF);
    // Serial.println(F("EOT BEACON"));
    sendBeaconTimer = (60 * repeatBeacon);
  }
}

void sendAM(void)
{ 
  uint8_t duration = 0;
  // Send AUDIO AM
  logs(INF);
  Serial.println(F("Send AM"));

  //PTT ON TELCO
  // logs(INF);
  // Serial.print(F("PTT ON..."));
  digitalWrite(CMDPTT, HIGH);
  delay(500);
  digitalWrite(SW_CW, LOW);
  digitalWrite(SW_AM, HIGH);
  delay(100);

  for(duration = 0; duration < (DURATION_AM * 2); duration++)
  {
    checkSecond();
    delay(500);
  }

  // PTT OFF
  digitalWrite(SW_CW, LOW);
  digitalWrite(SW_AM, LOW);
  digitalWrite(CMDPTT, LOW);
  // Serial.println(F("...PTT OFF"));
  // logs(INF);
  // Serial.println(F("EOT AM"));
}

void sendAck(int ack)
{
  if(ack == 0xAA)
  {
    // Send beacon
    logs(INF);
    Serial.println(F("Send ACK"));

    //PTT ON TELCO
    // logs(INF);
    // Serial.print(F("PTT ON..."));
    digitalWrite(CMDPTT, HIGH);
    delay(800);
    digitalWrite(SW_CW, HIGH);
    digitalWrite(SW_AM, LOW);
    delay(100);
    digitalWrite(MSG0_CW, LOW);
    digitalWrite(SOT_CW, HIGH);

    while(digitalRead(EOT_CW) == 0)
    {
      checkSecond();
      delay(30);
    }

    // PTT OFF
    digitalWrite(SOT_CW, LOW);
    digitalWrite(SW_CW, LOW);
    digitalWrite(SW_AM, LOW);
    digitalWrite(CMDPTT, LOW);
    // Serial.println(F("...PTT OFF"));
    // logs(INF);
    // Serial.println(F("EOT ACK"));
  }
}

// --  COMMAND D578  -----------------------------------------------------
int Pressed(uint8_t bp)
{
  int ackD578 = 0;
  
  bufferTX[4] = bp;
  bufferTX[2] = 0x01;
  swSerial.write(bufferTX, 8);  
  delay(200);  
  bufferTX[2] = 0x00;
  swSerial.write(bufferTX, 8);
  
  if(swSerial.available() > 0)
  {
    ackD578 = swSerial.read();
  }
  
  //ackD578 = ackD578 & 0x000000FF;

  Serial.println(ackD578, HEX);

  if(ackD578 == 0xAA)
  {
    return ackD578;
  }
  else
  {
    return 0;
  }
}

int longPressed(uint8_t bp)
{
  int ackD578 = 0;
  
  bufferTX[4] = bp;
  bufferTX[3] = 0x01;
  bufferTX[2] = 0x01;
  swSerial.write(bufferTX, 8);
  delay(200);  
  bufferTX[3] = 0x00;
  bufferTX[2] = 0x00;
  swSerial.write(bufferTX, 8);
  
  if(swSerial.available() > 0)
  {
    ackD578 = swSerial.read();
  }
  
  //ackD578 = ackD578 & 0x000000FF;

  Serial.println(ackD578, HEX);

  if(ackD578 == 0xAA)
  {
    return ackD578;
  }
  else
  {
    return 0;
  }  
}

void pttPressed(boolean onoff)
{
  // Enable PTT
  bufferTX[4] = bpPTT;
  bufferTX[3] = 0;
  bufferTX[2] = 0;    
  
  if(onoff)
  {
    bufferTX[1] = 0x01;    
  }
  else
  {
    bufferTX[1] = 0;
  }
  swSerial.write(bufferTX, 8);
}

void sendKeepAlive(void)
{
  swSerial.write(0x06);
}

// --  COMMAND TERMINAL  -------------------------------------------------
void cmdHelp()
{
    // Print usage
    Serial.println(F("Serial terminal usage:"));
    Serial.println(F("  ?                   Print this help"));
    Serial.println(F("  get                 Get Parameters"));
    Serial.println(F("  setBeacon           Set Beacon"));
    Serial.println(F("  setAuto             Set Start/Stop Auto"));
    Serial.println(F("  setDate             Set date RTC"));
    Serial.println(F("  setTime             Set time RTC"));
    Serial.println(F("  temp                Get Temperature"));
    Serial.println(F("  sav                 Save Parameters"));
    Serial.println(F("  v                   Print Version"));
}

void cmdGet()
{
	bool CenturyBit = false;
  bool h12Flag;
  bool pmFlag;

  Serial.print(F("Enable Beacon: "));
  Serial.println(enaBeacon);
  Serial.print(F("Repeat Beacon: "));
  Serial.println(repeatBeacon);

  // Get date
	Serial.print(rtc.getDate(), DEC);
	Serial.print("/");
	Serial.print(rtc.getMonth(CenturyBit), DEC);
	Serial.print("/");
  Serial.print(rtc.getYear(), DEC);
	Serial.print(' ');
	
  // Get Time
	Serial.print(rtc.getHour(h12Flag, pmFlag), DEC);
	Serial.print(":");
	Serial.print(rtc.getMinute(), DEC);
	Serial.print(":");
	Serial.print(rtc.getSecond(), DEC);
 
	// Add AM/PM indicator
	if (h12Flag) {
		if (pmFlag) {
			Serial.println(F(" PM"));
		} else {
			Serial.println(F(" AM"));
		}
	} else {
		Serial.println(F(" 24H"));
	}

  Serial.print(F("A1: "));
  Serial.print(a1Hour);
  Serial.print(F(":"));
  Serial.println(a1Minute);
  Serial.print(F("A2: "));
  Serial.print(a2Hour);
  Serial.print(F(":"));
  Serial.println(a2Minute);
}

void cmdSetBeacon()
{
  int val;
  char *arg;

  arg = term.getNext();
  if (arg == NULL)
  {
    Serial.println(F("DEC value not specified."));
    return;
  }
  else
  {
    if (sscanf(arg, "%d", &val) != 1)
    {
      Serial.println(F("Cannot convert DEC value."));
      return;
    }
  }
  enaBeacon = val;
  
  if(enaBeacon)
  {
    digitalWrite(LED, HIGH);
  }
  else
  {
    digitalWrite(LED, LOW);
  }

  Serial.print(F("Set Enable Beacon: "));
  Serial.println(enaBeacon, DEC);

  arg = term.getNext();
  if (arg == NULL)
  {
    Serial.println(F("DEC value not specified."));
    return;
  }
  else
  {
    if (sscanf(arg, "%d", &val) != 1)
    {
      Serial.println(F("Cannot convert DEC value."));
      return;
    }
  }
  repeatBeacon = val;
  sendBeaconTimer = (60 * repeatBeacon);
  Serial.print(F("Set Repeat Beacon: "));
  Serial.println(repeatBeacon, DEC);
}

void cmdSetAuto()
{
  int val;
  int buffer[4];
  char *arg;
  uint8_t i = 0;
  for(i = 0; i < 4; i++)
  {
      arg = term.getNext();
      if (arg == NULL)
      {
        Serial.println(F("DEC value not specified."));
        return;
      }
      else
      {
        if (sscanf(arg, "%d", &val) != 1)
        {
          Serial.println(F("Cannot convert DEC value."));
          return;
        }
      }

      buffer[i] = val;
  }

  a1Hour = buffer[0];
  a1Minute = buffer[1];
  setAlarm(1);
  a2Hour = buffer[2];
  a2Minute = buffer[3];
  setAlarm(2);
  Serial.print(F("Set Alarm A1: "));
  Serial.print(a1Hour);
  Serial.print(F(":"));
  Serial.println(a1Minute);
  Serial.print(F("Set Alarm A2: "));
  Serial.print(a2Hour);
  Serial.print(F(":"));
  Serial.println(a2Minute);  
}

void cmdSetDate()
{
  int val;
  int buffer[3];
  char *arg;
  uint8_t i = 0;
  for(i = 0; i < 3; i++)
  {
      arg = term.getNext();
      if (arg == NULL)
      {
        Serial.println(F("DEC value not specified."));
        return;
      }
      else
      {
        if (sscanf(arg, "%d", &val) != 1)
        {
          Serial.println(F("Cannot convert DEC value."));
          return;
        }
      }

      buffer[i] = val;
  }

  rtc.setDate(buffer[0]);
  rtc.setMonth(buffer[1]);
  rtc.setYear(buffer[2]); 
}

void cmdSetTime()
{
  int val;
  int buffer[3];
  char *arg;
  uint8_t i = 0;
  for(i = 0; i < 3; i++)
  {
      arg = term.getNext();
      if (arg == NULL)
      {
        Serial.println(F("DEC value not specified."));
        return;
      }
      else
      {
        if (sscanf(arg, "%d", &val) != 1)
        {
          Serial.println(F("Cannot convert DEC value."));
          return;
        }
      }

      buffer[i] = val;
  }

  rtc.setClockMode(false);
  rtc.setHour(buffer[0]);
  rtc.setMinute(buffer[1]);
  rtc.setSecond(buffer[2]); 
}

void cmdSave()
{
  int addr = 0;  

  // write to EEPROM.
  EEPROM.write(addr, enaBeacon); 
  addr++;
  EEPROM.write(addr, repeatBeacon);
  addr++;
  EEPROM.write(addr, a1Hour);
  addr++;
  EEPROM.write(addr, a1Minute);
  addr++;
  EEPROM.write(addr, a2Hour);
  addr++;
  EEPROM.write(addr, a2Minute);      
  Serial.println("Save Configuration");

}

void cmdTemp()
{
  Serial.print(F("INT Humidite: "));
  Serial.print(SensorInt.readFloatHumidity(), 1);
  Serial.println(F("%"));

  Serial.print(F("INT Pression: "));
  Serial.print((SensorInt.readFloatPressure() / 100), 1);
  Serial.println(F(" hPa"));

  Serial.print(F("INT Temperature: "));
  Serial.print(SensorInt.readTempC(), 1);
  Serial.println(F("°"));

    Serial.print(F("EXT Humidite: "));
  Serial.print(SensorExt.readFloatHumidity(), 1);
  Serial.println(F("%"));

  Serial.print(F("EXT Pression: "));
  Serial.print((SensorExt.readFloatPressure() / 100), 1);
  Serial.println(F(" hPa"));

  Serial.print(F("EXT Temperature: "));
  Serial.print(SensorExt.readTempC(), 1);
  Serial.println(F("°"));
}

void cmdVersion()
{
    // Print usage
    Serial.print(F("VERSION: "));
    Serial.println(VERSION);
}

void cmdUnknown(const char *command)
{
    // Print unknown command
    Serial.print(F("Unknown command: "));
    Serial.print(command);
    Serial.println(F(", '?' for help"));
}

void printConsoleChar(void)
{
    Serial.print(F("> "));
}

// --  PIO  -------------------------------------------------------------
void enableRelay(uint8_t num, bool state)
{
  if(state)
  {
    pio.write((8 + (num * 2)), LOW);
    pio.write((8 + (num * 2) + 1), HIGH);
    delay(150);
    pio.write((8 + (num * 2) + 1), LOW);
  }
  else
  {
    pio.write((8 + (num * 2) + 1), LOW);
    pio.write((8 + (num * 2)), HIGH);
    delay(150);
    pio.write((8 + (num * 2)), LOW);
  }
}

// --  MISC  -------------------------------------------------------------
void logs(uint8_t level)
{
  switch (level)
  {
  case 0:
    Serial.print(F("I: "));
    break;
  case 1:
    Serial.print(F("W: "));
    break;
  case 2:
    Serial.print(F("E: "));
    break;

  }
}

void checkSecond(void)
{
  if ((millis() - lastSecond) >= 1000)
  {
    lastSecond = millis();
    sendKeepAlive();
    sendBeaconTimer--;
      
    if(dtmfTimer > 0 )
    {
      dtmfTimer--;
    }
  }
}
