f4ise/RemoteAnyToneD578/(commit log)

2025-09-07 Manage Press short, Press Long for A, B, C and D touch
    [main.cpp]
2025-09-25 Update Code, Add schematic, Add Docs
    [RemoteDTMF.kicad_sch, hex_keys.xlsx]
2025-09-25 Update schematic, add PCB and Gerber
    [RemoteDTMF.kicad_pcb, RemoteDTMF.kicad_sch]
2025-09-26 Comment Schematic, add PDF
    [RemoteDTMF.kicad_sch]
2025-09-26 Update Gerber
    [RemoteDTMF.kicad_pcb]
2025-09-30 WIP 0.6A & Schematic
    - Support D578 microphone ACK
    - Update schematic
    [RemoteDTMF.kicad_sch]
2025-10-04 Update Schematic & WIP 0.6A
    [RemoteDTMF.kicad_pcb, RemoteDTMF.kicad_sch]
2025-10-04 WIP Update PCB
2025-10-05 WIP Update PCB 2
    [RemoteDTMF.kicad_pcb, RemoteDTMF.kicad_sch]
2025-10-05 WIP Update PCB 3
    [RemoteDTMF.kicad_pcb, RemoteDTMF.kicad_sch]
2025-10-07 WIP Update PCB 4
    [RemoteDTMF.kicad_pcb, RemoteDTMF.kicad_sch]
2025-10-07 Update 0.6A
    - Add relays
    - Add PIO
2025-10-08 Update to 0.7A
    - Change DTMF command
    - Bug fix ACK UART D578
    [config.h, main.cpp]
2025-10-18 Update 0.9A + Hardware Mega
    - Add EXT BME280
    - Update Doc
    - Add Schematic Remote_Mega
    [RemoteDTMF_Mega.kicad_pcb, RemoteDTMF_Mega.kicad_sch]
2025-10-30 Update projet
    - Clean Hardware folder
    [RemoteDTMF.kicad_pcb, RemoteDTMF.kicad_sch]
